sebseb7/LipoManager/pcb.jpg

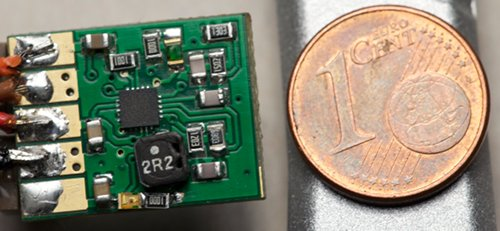
pcb.jpg
