sebseb7/LipoManager/top.jpg

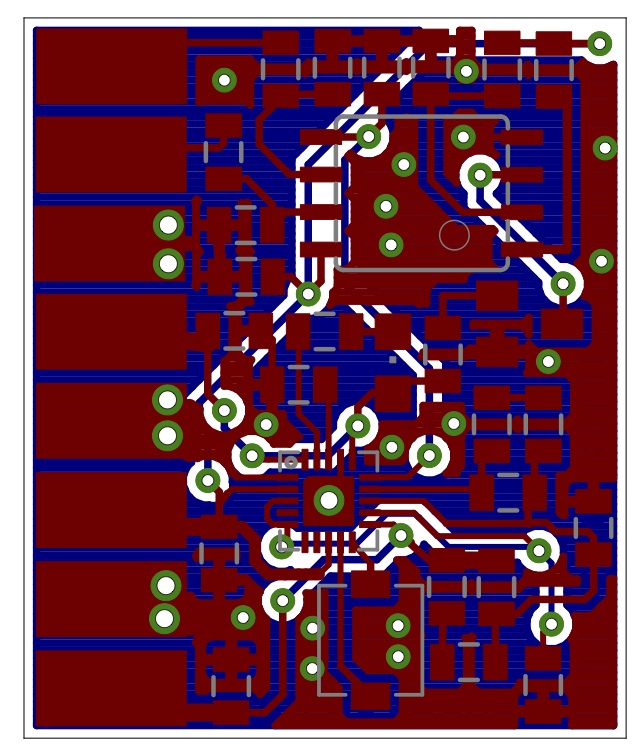
top.jpg
