sebseb7/LipoManager/names.jpg

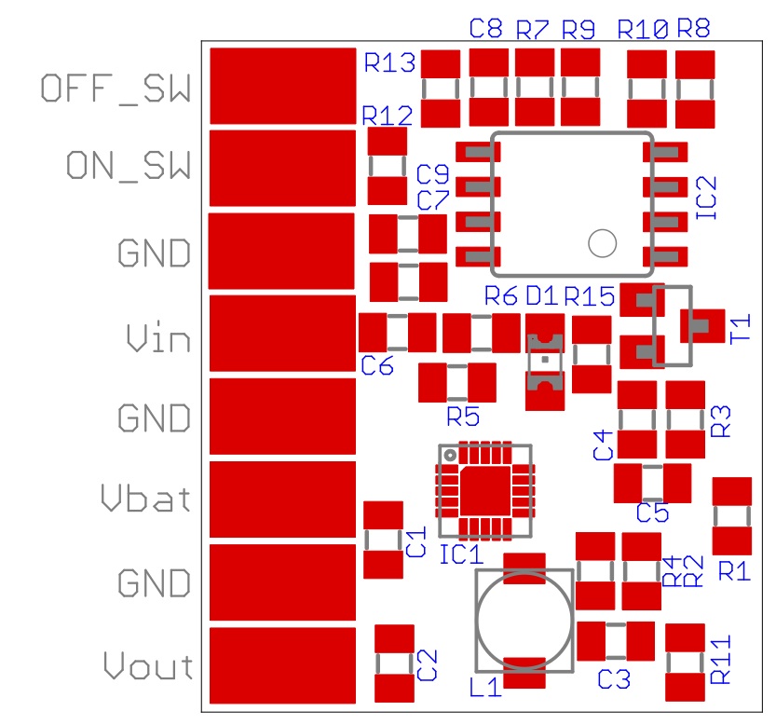
names.jpg
