sebseb7/LipoManager/schematics.jpg

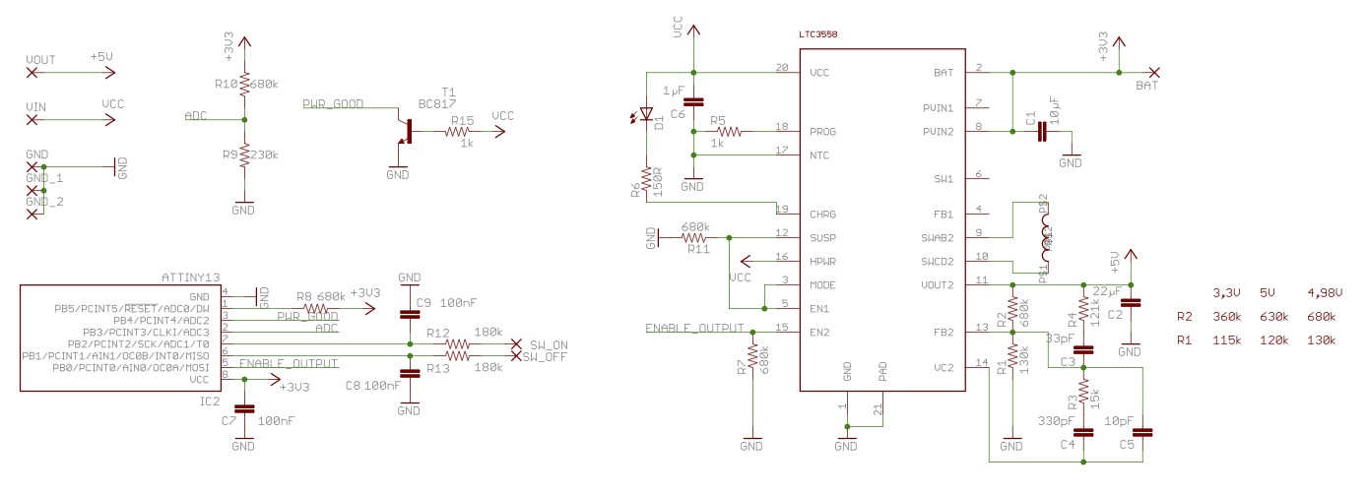
schematics.jpg
