sebseb7/LipoManager/values.jpg

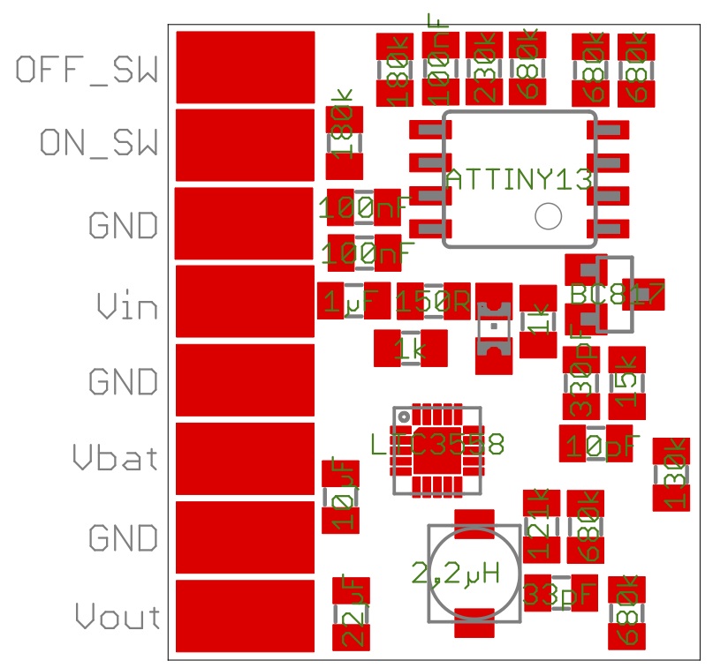
values.jpg
