sebseb7/LipoManager/(commit log)

2011-07-11 eagle files
    [lipo.brd, lipo.sch]
2011-07-12 changed SOIC from 150mil to 200mil
    [lipo.brd, lipo.sch]
2011-07-12 Distance improovements
    [lipo.brd]
2011-07-13 tuned resistor values
    [lipo.brd, lipo.sch]
2011-07-13 some changes were not included in the last commit
    [lipo.brd, lipo.sch]
2011-07-13 set uvlo values on bootup if on-button is pressed
2011-07-14 added pcb image
2011-07-15 github seems to have utf8 problems
    [main.c]
2011-07-15 transition to new layout
    [lipo.brd, lipo.sch]
2011-07-17 added pwrgood sense
    [lipo.brd, lipo.sch]
2011-07-19 added resistor documentation
    [lipo.brd, lipo.sch]
2011-08-05 layout optimization & schematics beautify
    [lipo.brd, lipo.sch]
2011-08-05 added pad descriptions to tDocu layer
    [lipo.brd]
2011-08-05 beautified tValues layer
    [lipo.brd]
2011-08-09 PNin1 needs to be connecte even if the buck regulator is not in use (saves 30uA)
    [lipo.brd, lipo.sch]
2011-08-09 added switchless mode
2011-08-09 removed hardware debuncer (no advantage in this case)
    [lipo.brd, lipo.sch]
2011-08-17 small updates
    [lipo.brd]
2011-08-17 added buck only version
    [lipo2.brd, lipo2.sch]
2011-08-17 changed inductor
    [lipo2.brd, lipo2.sch]
2011-08-17 changed resitor values
    [lipo2.brd, lipo2.sch]
2011-08-18 changed uvlo values
    [lipo.brd, lipo.sch]
2011-08-19 final touches
    [lipo.brd, lipo.sch, lipo2.brd, lipo2.sch]
2011-08-19 molex picoblade instead of PADs
    [lipoMolex.brd, lipoMolex.sch]
2011-08-19 consitent part naming
    [lipo2.brd, lipo2.sch, lipoMolex.brd, lipoMolex.sch]
2011-08-19 QFN Layout changed
    [lipo.brd, lipo.sch, lipo2.brd, lipo2.sch, lipoMolex.brd, lipoMolex.sch]
2011-08-19 moved FB resistors
    [lipo.brd]
2011-08-21 readded version 1.1
    [lipo_v1_1.brd, lipo_v1_1.sch]
2011-08-22 fixed timer prescaler & added new switchless_fulloff mode
    [lipo_v1_1.brd, lipo_v1_1.sch]
2011-08-22 fixed assembly documentation
    [lipo_v1_1.brd]
2011-08-22 fixed switchless_fulloff mode
2011-08-22 actived SW_ON for switchless_fulloff mode
2011-08-24 added restart delay and emergency-poweroff
2011-09-09 new inductor
    [lipo.brd, lipo.sch, lipo2.brd, lipo2.sch]
2011-09-10 exchanged inductors
    [lipo.brd, lipo.sch, lipo2.brd, lipo2.sch]
2011-09-14 added missing L value
    [lipo2.brd, lipo2.sch]
2011-09-14 added inductor value
    [lipo.brd, lipo.sch]
2011-09-17 small GND fix
    [lipo.brd]
2011-10-19 fixed two button mode
    [main.c]
2011-10-19 minor updates
    [lipo.sch, lipoMolex.brd, lipoMolex.sch, lipo_v1_1.brd, lipo_v1_1.sch]
2012-02-15 6 single cell chargers
    [6lipo.brd, 6lipo.sch]
